Alessio-Lovato-Unipd/Embedded-system-prototyping/README.md

# Embedded-system-prototyping
Design of a PCB based on specs given as assignment in Embedded System Prototyping course in Sundsvall's University during Erasmus exchange programme

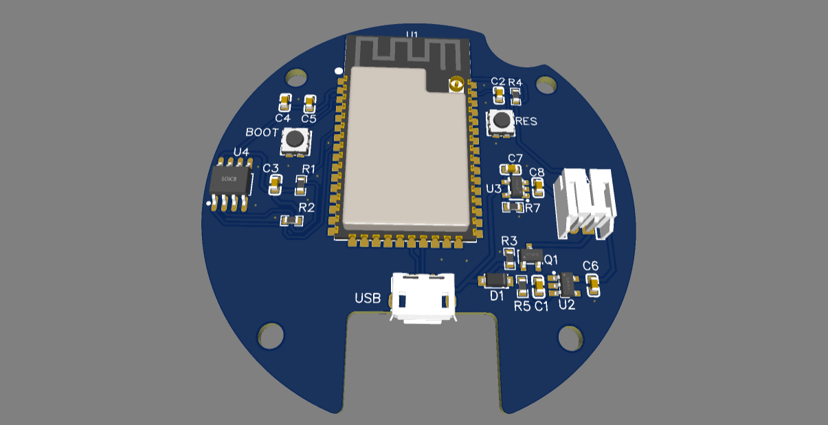
[picture p1: images/pcb_image.PNG]
Image of the prototyped pcb Prototyped PCB
