Alessio-Lovato-Unipd/Embedded-system-prototyping/Note.txt

CONNESSIONE USB -ESP32S2
https://docs.espressif.com/projects/esp-idf/en/latest/esp32s2/get-started/establish-serial-connection.html
https://docs.espressif.com/projects/esp-idf/en/v4.3/esp32s2/api-guides/usb-console.html

STANDARD PIN USB
https://www.arrow.com/en/research-and-events/articles/micro-connector-usb-pinout

USB/Battery Switch:
https://electronics.stackexchange.com/questions/409496/automatic-charging-and-power-switch-between-usb-and-lipo-battery
(upper design)
