Alessio-Lovato-Unipd/Embedded-system-prototyping/project_files/BOM_Indoor_WiFi_temperature_sensor.csv

ID | Name | Designator | Footprint | Quantity | Manufacturer Part | Manufacturer | Supplier | Supplier Part | Price
1 | S2B-PH-K-S(LF)(SN) | BAT | CONN-TH_S2B-PH-K-S-LF-SN | 1 | S2B-PH-K-S(LF)(SN) | JST | Digi-Key | 455-1719-ND
2 | 10uF | C1,C6 | C0603 | 2 | CL10A106MP8NNNC | Samsung Electro-Mechanics | Digi-Key | 1276-1871-1-ND
3 | 0.01uF | C3 | C0603 | 1 | GRM033R61A103KA01J | Murata Electronics | Digi-Key | 490-8156-1-ND
4 | MBR120LSFT1G | D1 | SOD-123_L2.8-W1.8-LS3.7-RD | 1 | MBR120LSFT1G | onsemi(安森美) | Digi-Key | MBR120LSFT1GOSCT-ND
5 | DMG3415UQ-7 | Q1 | SOT-23-3_L2.9-W1.6-P1.90-LS2.8-BR | 1 | DMG3415UQ-7 | DIODES(美台) | Digi-Key | 31-DMG3415UQ-7CT-ND
6 | ESP32-S2-WROOM-I-N4 | U1 | WIFI-SMD_ESP32-S2-WROVER-I | 1 | ESP32-S2-WROOM-I-N4 | ESPRESSIF(乐鑫) | Digi-Key | 1965-ESP32-S2-WROOM-I-N4CT-ND
7 | AP2112K-3.3TRG1 | U2 | SOT-25-5_L3.0-W1.8-P0.95-LS3.0-BR | 1 | AP2112K-3.3TRG1 | DIODES(美台) | Digi-Key | AP2112K-3.3TRG1DICT-ND
8 | R-667842 | BOOT,RES | SW-SMD_MITSUMI_R-667842 | 2 | R-667842 | MITSUMI(美上美) | Digi-Key | 2508-R-667842CT-ND
9 | 0.1uF | C2,C5 | C0603 | 2 | C0603X104K050T | Holy Stone Enterprise Co., Ltd. | Digi-Key | 4587-C0603X104K050TCT-ND
10 | 22uF | C4 | C0603 | 1 | C1608X5R1A226M080AC | TDK Corporation | Digi-Key | 445-9077-1-ND
11 | 4.7uF | C7,C8 | C0603 | 2 | GRM188Z71A475KE15J | Murata Electronics | Digi-Key | 490-GRM188Z71A475KE15JCT-ND
12 | 2k | R7 | R0603 | 1 | RNCP0603FTD2K00 | Stackpole Electronics Inc | Digi-Key | RNCP0603FTD2K00CT-ND
13 | MCP73831T-2ACI/OT | U3 | SOT-23-5_L3.0-W1.7-P0.95-LS2.8-BR | 1 | MCP73831T-2ACI/OT | MICROCHIP(美国微芯) | Digi-Key | MCP73831T-2ACI/OTCT-ND
14 | TMP1075DR | U4 | SOIC-8_L4.9-W3.9-P1.27-LS6.0-BL | 1 | TMP1075DR | TI(德州仪器) | Digi-Key | 296-51833-1-ND
15 | 105017-0001 | USB | MICRO-USB-SMD_105017-0001 | 1 | 1050170001 | MOLEX | Digi-Key | WM1399CT-ND
16 | 5k | R1,R2 | R0603 | 2 | CR0603-FX-4991ELF | Bourns Inc. | Digi-Key | CR0603-FX-4991ELFCT-ND
17 | 100k | R3,R5 | R0603 | 2 | CR0603-FX-1003ELF | Bourns Inc. | Digi-Key | CR0603-FX-1003ELFCT-ND
18 | 10k | R4 | R0603 | 1 | CR0603AFX-1002EAS | Bourns Inc. | Digi-Key | CR0603AFX-1002EASCT-ND
