Alessio-Lovato-Unipd/Embedded-system-prototyping/project_files/pcb_outline_border.dxf

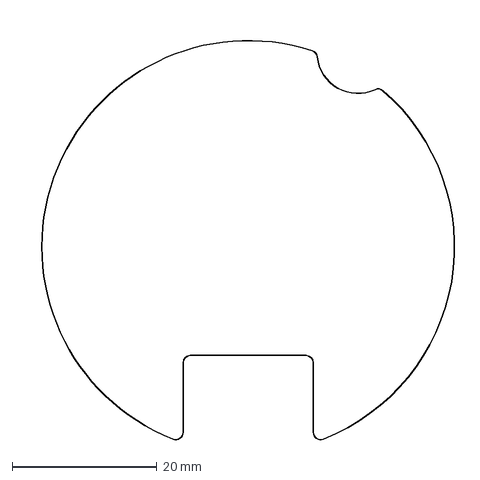
[picture p5: CAD file, 2023-02-22]
project_files/pcb_outline_border.dxf
61.8 x 58.6 mm
