Alessio-Lovato-Unipd/Embedded-system-prototyping/project_files/Schematic_indoor_WiFi_temperature_sensor.pdf

IO18 21 IO19 22 IO20 23 IO21 24 IO26 25 GND 26 IO33 27 IO34 28 IO35 29 IO36 30 IO37 31 IO38 32 IO39 33 IO40 34 IO41 35 IO42 36 TXD0 37 RXD0 38 IO45 39 IO46 40 EN 41 GND 42 EP 43

## BOOTLOAD BUTTON

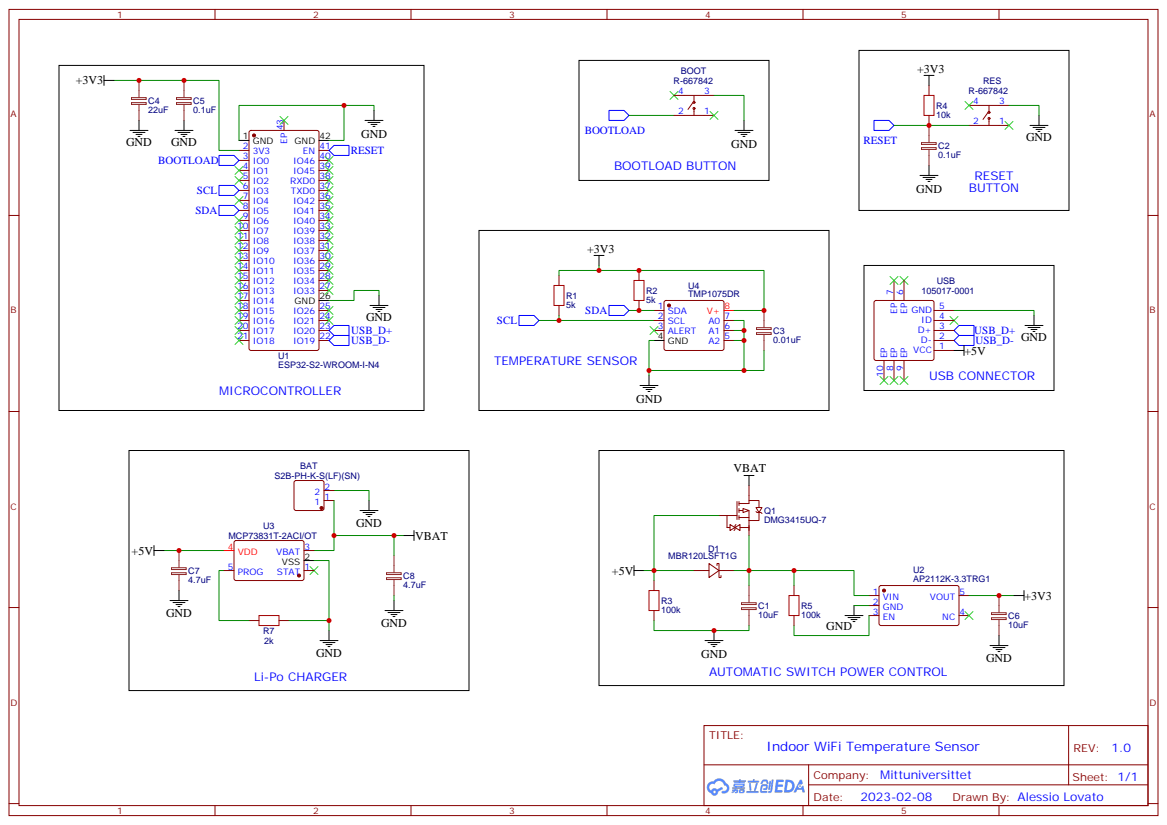
[picture p6: page 1]

GND
AUTOMATIC SWITCH POWER CONTROL

Drawn By: Alessio Lovato
