Alessio-Lovato-Unipd/Embedded-system-prototyping/(list of files, drawings)

Other design files:
project_files/json_files_EasyEda/1-PCB_PCB_Indoor WiFi temperature sensor.json
project_files/json_files_EasyEda/1-Schematic_Indoor WiFi temperature sensor.json
