Alessio-Lovato-Unipd/Embedded-system-prototyping/(commit log)

2023-02-09 Datasheet of Buttons, temperature sensor, micro USB connector and voltage regulator
2023-02-09 Changed the design of power regulation. Now the device can be charged and powered via micro-usb and when the cable is disconnected, the device works with Li-po battery
    For more information see https://electronics.stackexchange.com/questions/409496/automatic-charging-and-power-switch-between-usb-and-lipo-battery
2023-02-09 Added antenna components to list but not found in EasyEDA components library
2023-02-10 Added datasheets of capacitors and resistences use in battery charger
2023-02-13 Antenna is builted in the ESP-32
2023-02-14 Changed button. This way we have more grip on the board. Two pins are floating.
2023-02-22 Changed temperature sensor
2023-02-22 Added PCB border layout
    [pcb_outline_border.dxf]
2023-02-22 Schematic version 1.0
2023-02-22 Generated gerber file to produce PCB
2023-02-22 Generated BOM
    [BOM_Indoor_WiFi_temperature_sensor.csv]
2023-02-22 Updated datasheets of Li-Po charger components
2023-02-22 added datasheets Automatic switch power control
2023-02-22 Added temperature sensor components datasheets
2023-02-22 Added buttons components datasheets
2023-02-22 Added missing diode datasheet
2023-02-22 Updated json file to import project in EasyEda to last version
    [1-PCB_PCB_Indoor WiFi temperature sensor.json, 1-Schematic_Indoor WiFi temperature sensor.json]
2023-02-22 Added text on the bottom side of the board
    [1-PCB_PCB_Indoor WiFi temperature sensor.json, BOM_Indoor_WiFi_temperature_sensor.csv]
2023-03-12 Changed capacitor C3. The capacitor choosen had the wrong size
    [1-PCB_PCB_Indoor WiFi temperature sensor.json, 1-Schematic_Indoor WiFi temperature sensor.json]
